Sakura-IT/decelerator4030/README.md

decelerator4030
===============

Decelerator 4030 CPU card for Amiga 3000/4000
