Sakura-IT/decelerator4030/docs/menu-specification/menu-layout.png

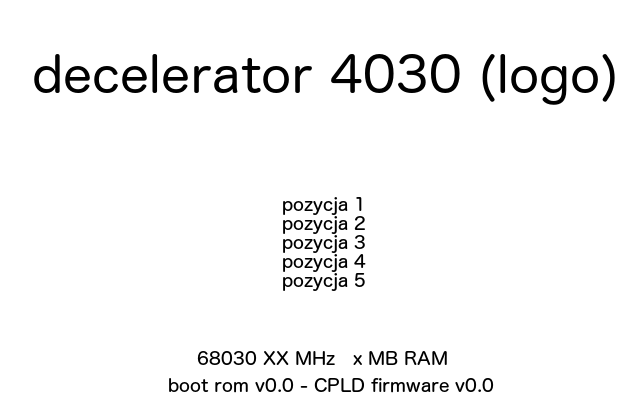
docs/menu-specification/menu-layout.png
