Sakura-IT/decelerator4030/(threads)

Thread 1 (2015-09-02):

Cannot open PCB file with latest (dev) version of pcbnew

timtashpulatov, 2015-09-02:
There seem to be a problem opening the PCB with recent versions of pcbnew. Would hate using kicad from year 2013, especially on Linux :)

rkujawa, 2015-09-02:
Yes, there's a problem, which either is a bug in KiCad, or something specific in this project. It's highly annoying but I didn't find any solution yet.

Personally I have a CentOS 6 VM for this purpose. Appropriate KiCad version from 2013 is available in EPEL for CentOS/RHEL 6. So I just ssh -X into this VM, which gives near-native experience.

I think I should ask on kicad mailing list about this instead...

sleary78, 2015-10-22:
I also experienced this issue. It cannot find any of the layers.

---------------------------
Error
---------------------------
Error loading board.
IO_ERROR: Layer 'Kleju_Dolna' in file 'C:\Users\stephen\Downloads\decelerator4030-master\board\v0.2\decelerator4030.kicad_pcb' at line 19, is not in fixed layer hash
from C:/Jenkins/workspace/windows-kicad-msys2-stable/src/kicad-4.0.0-rc1/pcbnew/pcb_parser.cpp : parseLayers() : line 829
---------------------------
OK
---------------------------

sleary78, 2015-10-22:
Perhaps related to https://forum.kicad.info/t/cant-open-the-demo-with-pcbnew/456

rkujawa, 2015-10-22:
Yes, exactly, as I mentioned above the current workaround is to use the older KiCad version. Personally I am using:
`$ rpm -q kicad`
`kicad-2013.06.11-1.rev4021.el6.x86_64`

Thread 2 (2015-12-09):

Problems with Decelerator prototype v0.2

rkujawa, 2015-12-09:
Lets use this issue to track problems with PCB design v0.2

- Provide a way to terminate the `_FPUCS` by generating `_BERR` when FPU is absent.
- Some local bus slot pins are incorrectly numbered (rows 2/3 and 6/7).
- Provide a way to block `_AS`/`_DS` delivery to main board, in case we are decoding the address on a card (not really a problem now, as we just use `_RAMSLOT`, but in the future we might want to decode it in CPLD).
- Connect `_CIIN` to CPLD, without that we can't control cache inhibit and possibly violate timings.
- Pins 119 and 120 of QFP are mismatched.

rkujawa, 2015-12-12:
Local bus slot pin numbering fixed by @jarob10 commit Sakura-IT/kicad-myparts@5dbb072d767a63a529620fdeb88b01f66f8d56a8 .

rkujawa, 2015-12-17:
`_BERR` generation when FPU is absent and QFP CPU pins mismatch fixed by @jarob10 commit c009a9950c43db73c895c168a1be03c1ebc944dd.

jarob10, 2015-12-20:
Connect _CIIN to CPLD and add pullup resistors to the Jtag by @jarob10 commit 28ce795.

jarob10, 2015-12-20:
Fix wrong PCB dimensions in rev0.3 board by @jarob10 commit 6349a9f

Thread 4 (2021-01-09):

synchronous or asynchronous operation

dymczykm, 2021-01-09:
Hi, I'm digging a bit into 68030 accelerators for old compact Macs and came across your project, it's a really neat design and a good example of interfacing a CPU to the bus.

One question that I wanted to ask if - have your ever run decelerator asynchronously w.r.t. to the system bus? My system bus operates at 16 MHz, but I would like to have 68030 at a higher frequency. Looking (briefly) at your logic equations, it seems that so far you have only forwarded the bus signals to the CPU without taking care of differing frequencies, is that correct?

Pozdrawiam!

rkujawa, 2021-01-09:
@dymczykm Correct, due to personal circumstances the project has been indefinitely delayed.

The original idea was to run the CPU asynchronously, however I have never got into that and the prototype (successfully) ran synchronously to the Amiga bus.

dymczykm, 2021-01-09:
Thanks for the quick answer - I more or less know where I stand now. In any case, the decelerator project can serve me as a nice hardware reference, thanks a lot for making it open source! :+1:

I'm not much acquainted with the Amiga world, but do you have maybe any good references regarding the asynchronous 68030 operation? I saw LUCAS and terriblefire accelerators do that for 68000->68030, I was curious if you know of logic description for 68030 or do I need to develop it from scratch.

Take care!

rkujawa, 2021-01-09:
I am not aware of any open source designs that would interface to the 68030 bus.

I think it boils down to the implementation details of the platform that you are targeting. In case of big box Amigas the local bus slot allows for both synchronous and asynchronous operation. It is even possible to drive the mainboard clocks from the CPU card. So in theory the logic on CPU board is only responsible for keeping the timings towards motherboard within limits. Unfortunately I don't remember details anymore. But I imagine in Macs it can be very different.

dymczykm, 2021-01-09:
@rkujawa thanks for the explanation. So I think some reverse engineered Mac accelerators and a 68030 User's manual will be my friends :)

Indeed, this seems to be more complex in Macs. You basically need to glue all the bus control signals (such as DSACKx, AS, DS etc. ) manually to make sure slower devices can successfully exchange data on the bus.

Thanks in any case - already a hardware concept you're sharing will be of great help!

rkujawa, 2021-01-10:
@dymczykm I guess this can be closed. Btw. If necessary you can always contact me using email address, as in commit messages of this repo.

Closed 2021-01-10.
