Sakura-IT/decelerator4030/board/v0.3/decelerator4030.kicad_pcb

## KiCad design board/v0.3/decelerator4030.kicad_pcb (2015-12-19)

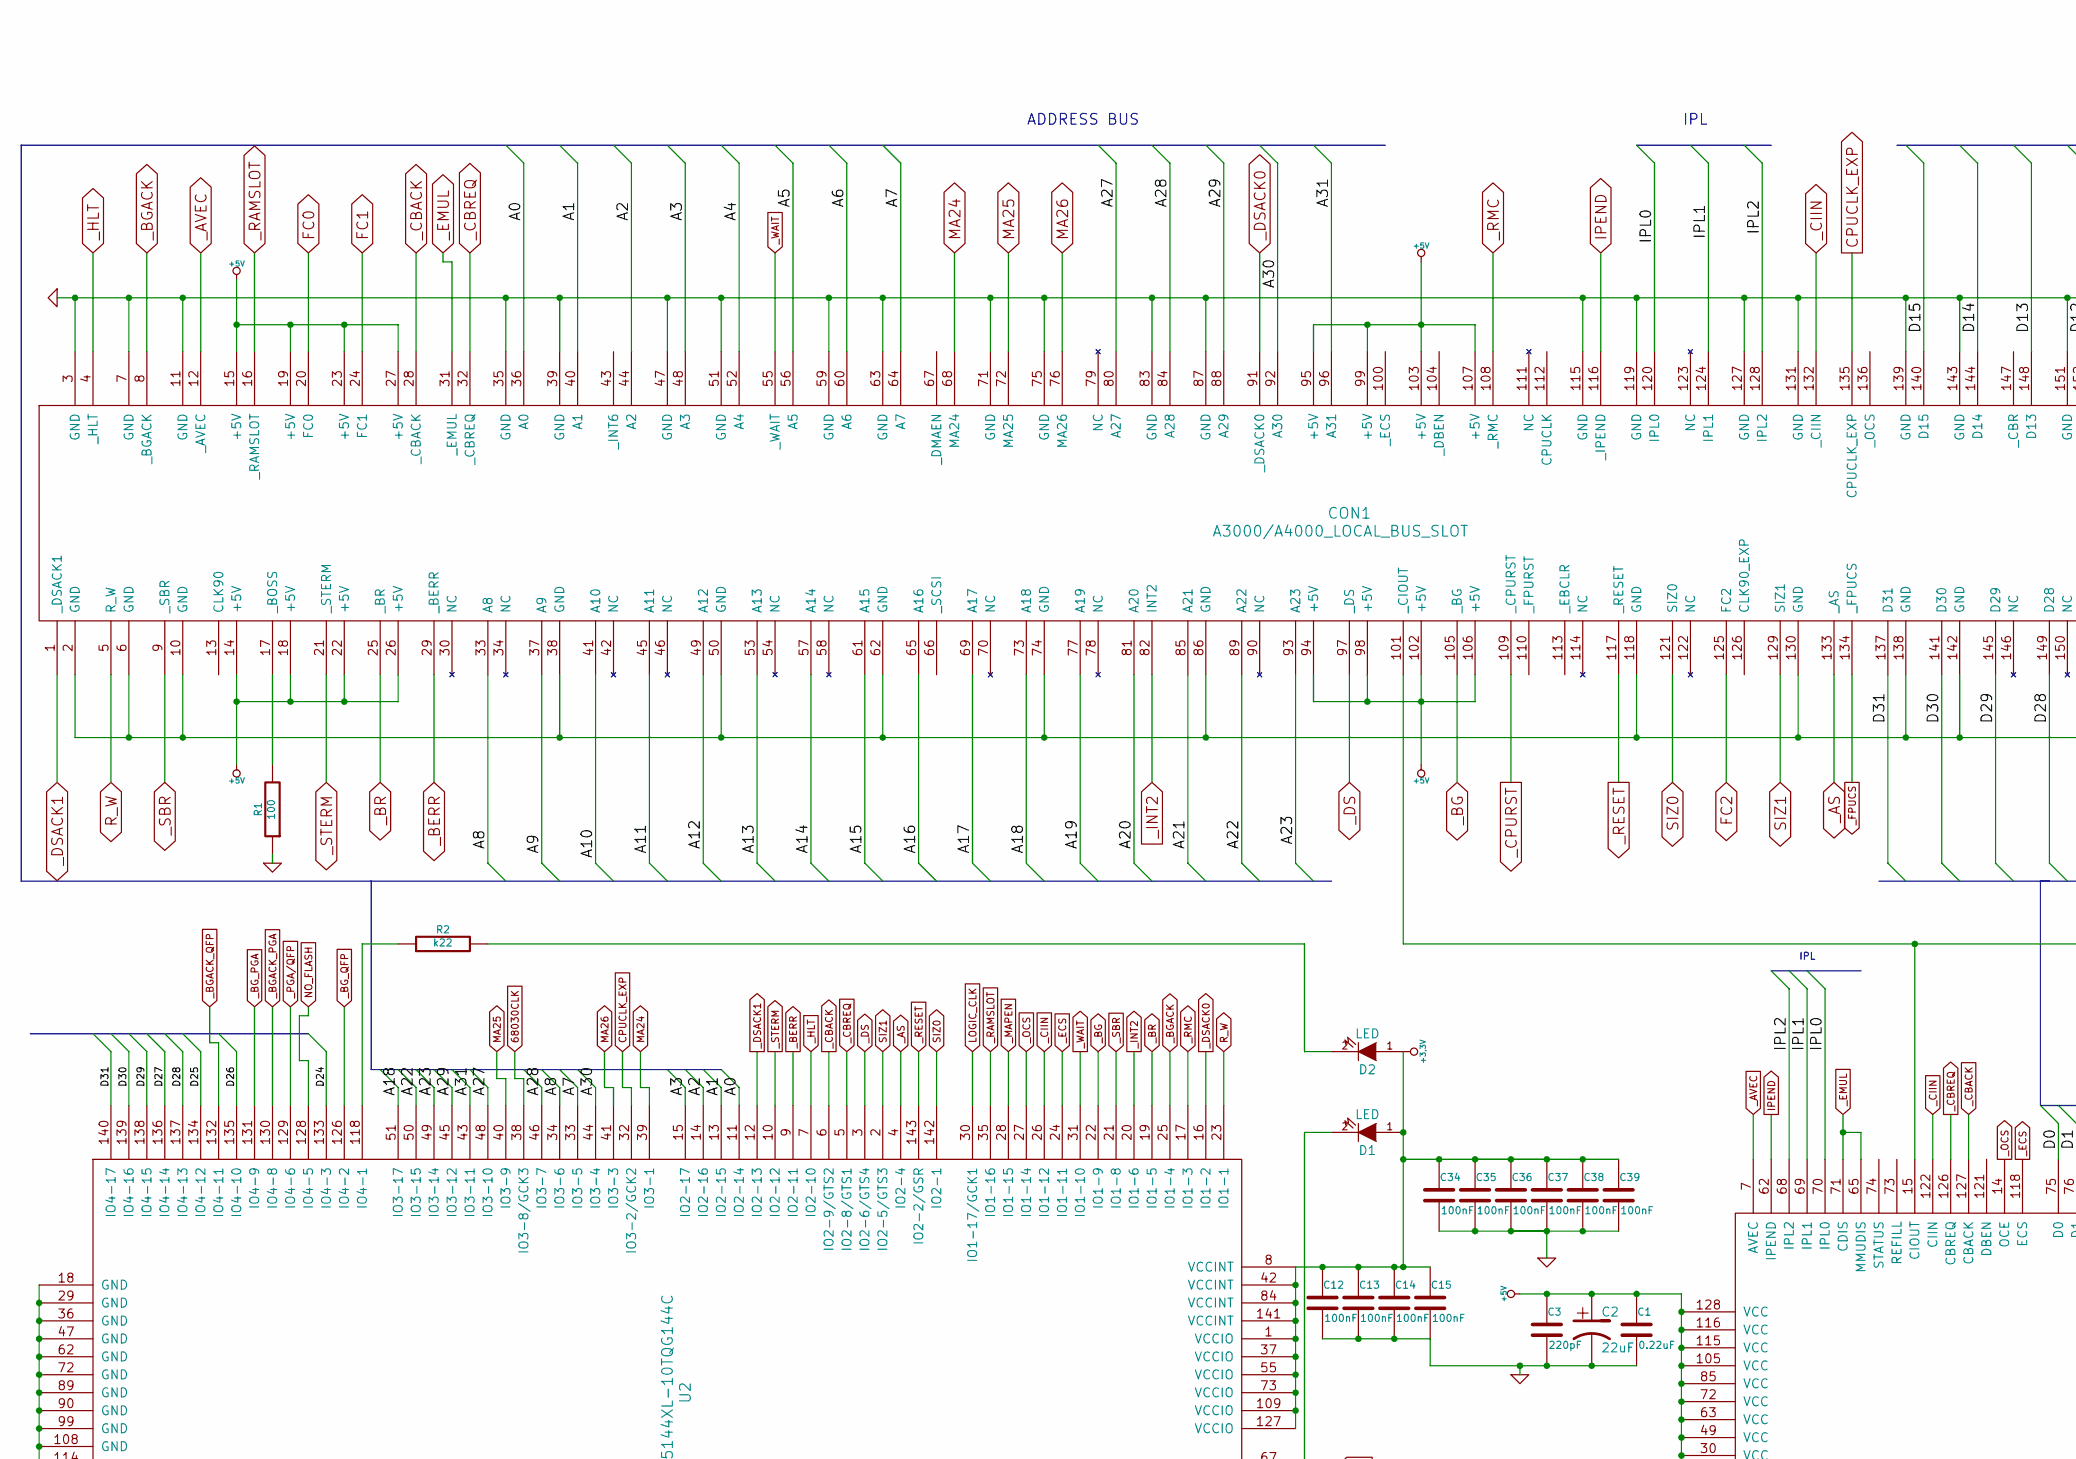
[picture p2: schematic decelerator4030.sch, part in row 1, column 1]

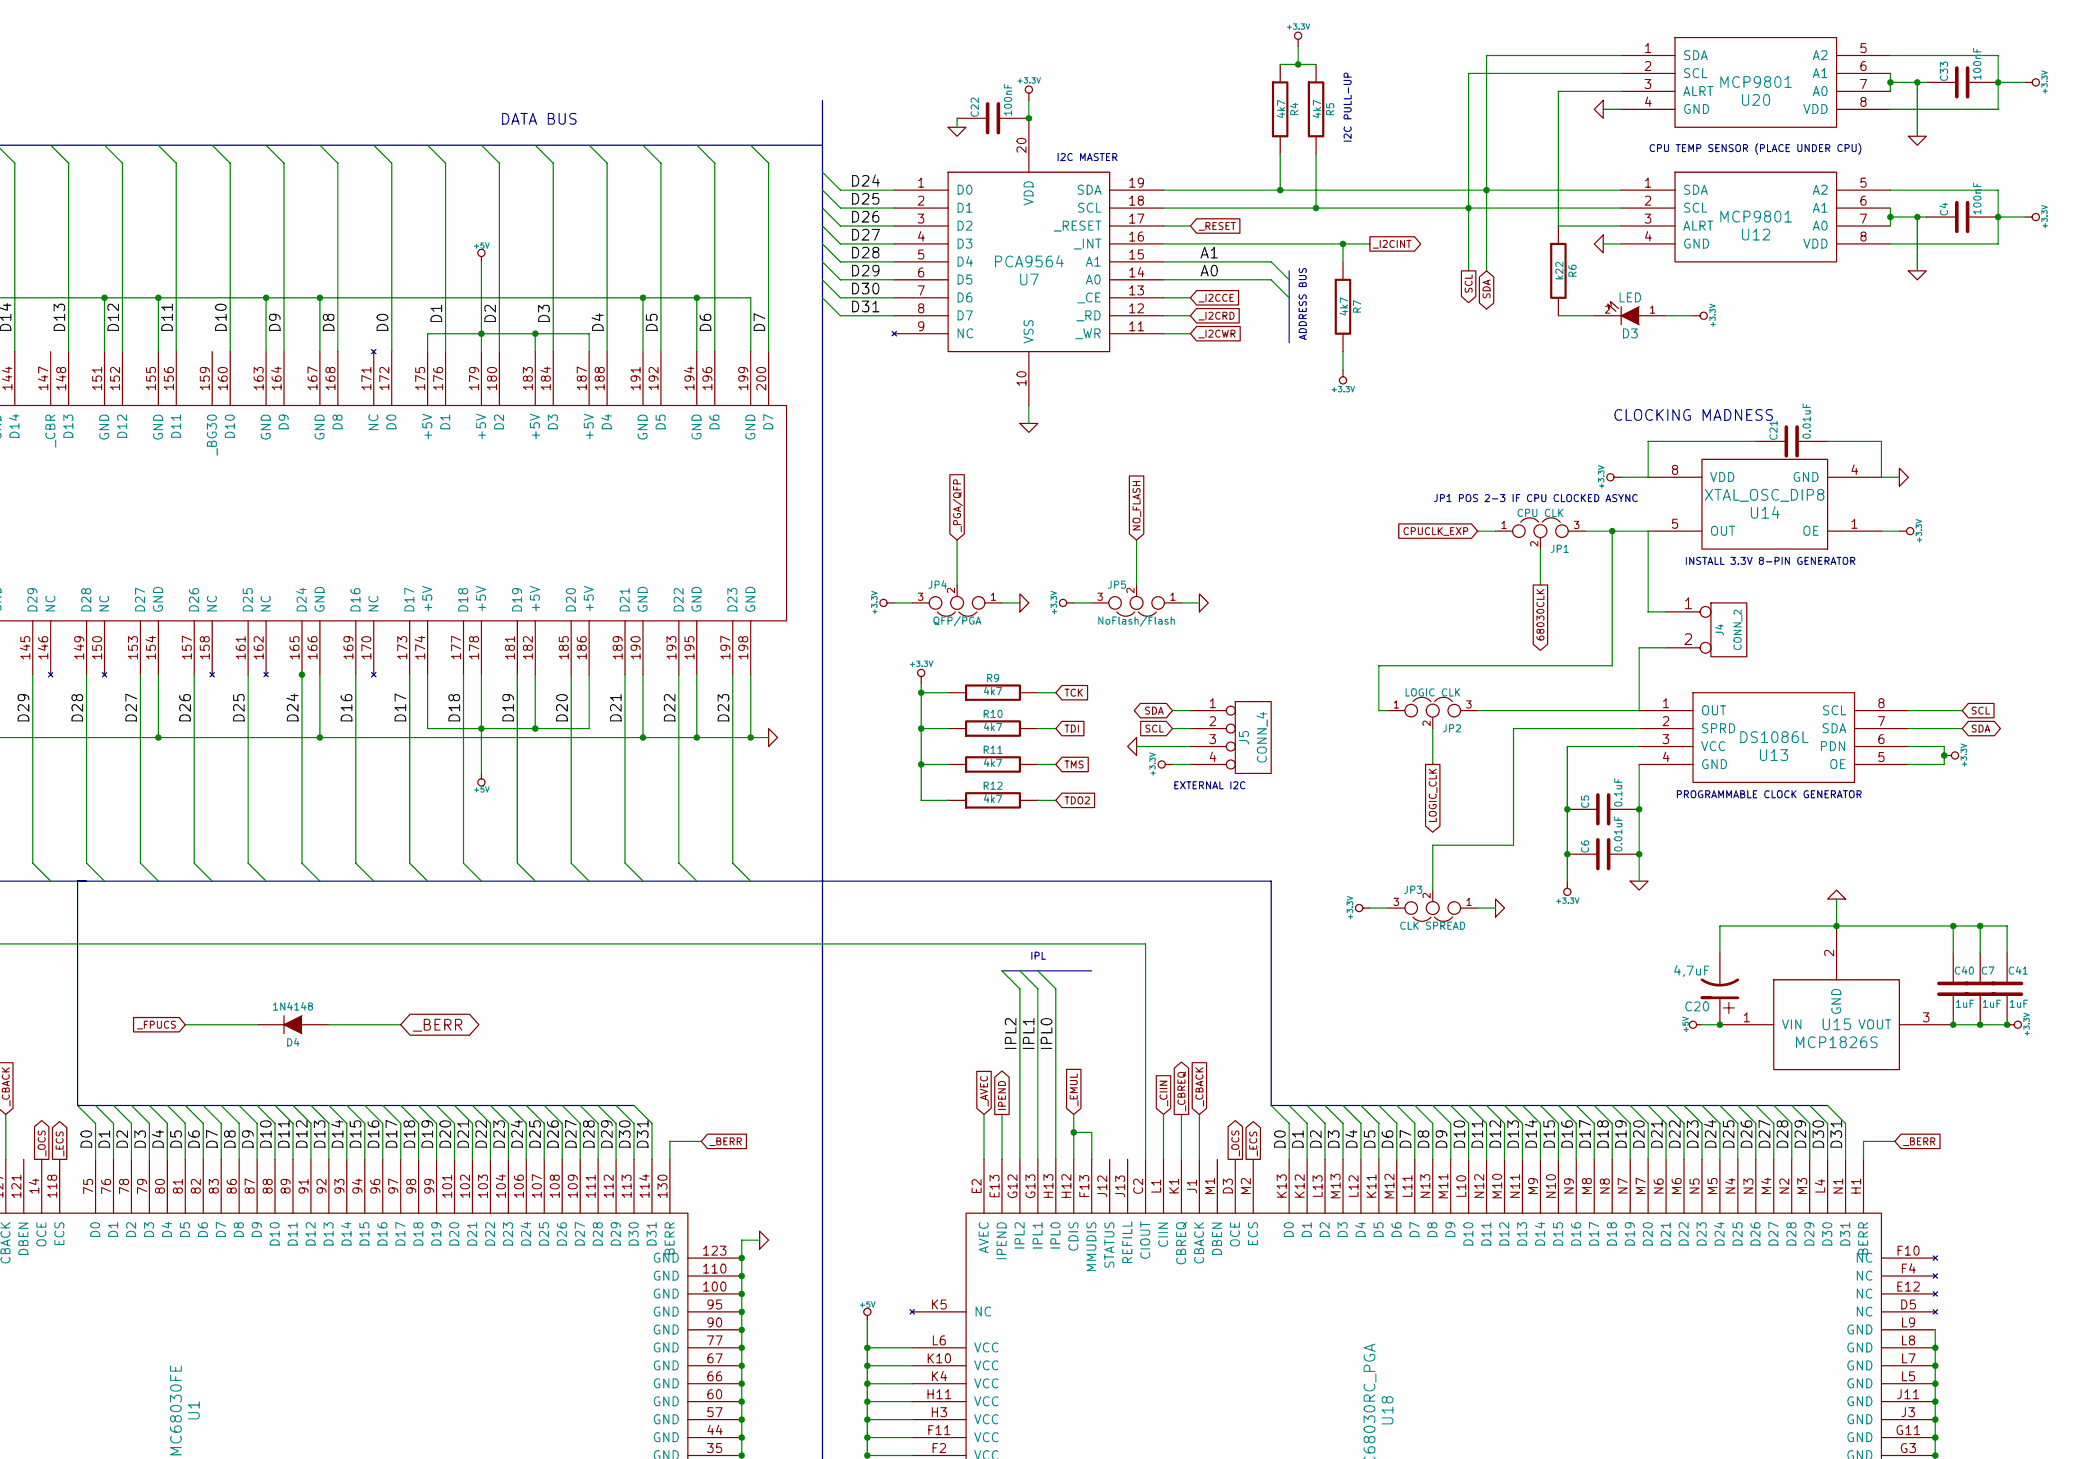
[picture p3: schematic decelerator4030.sch, part in row 1, column 2]

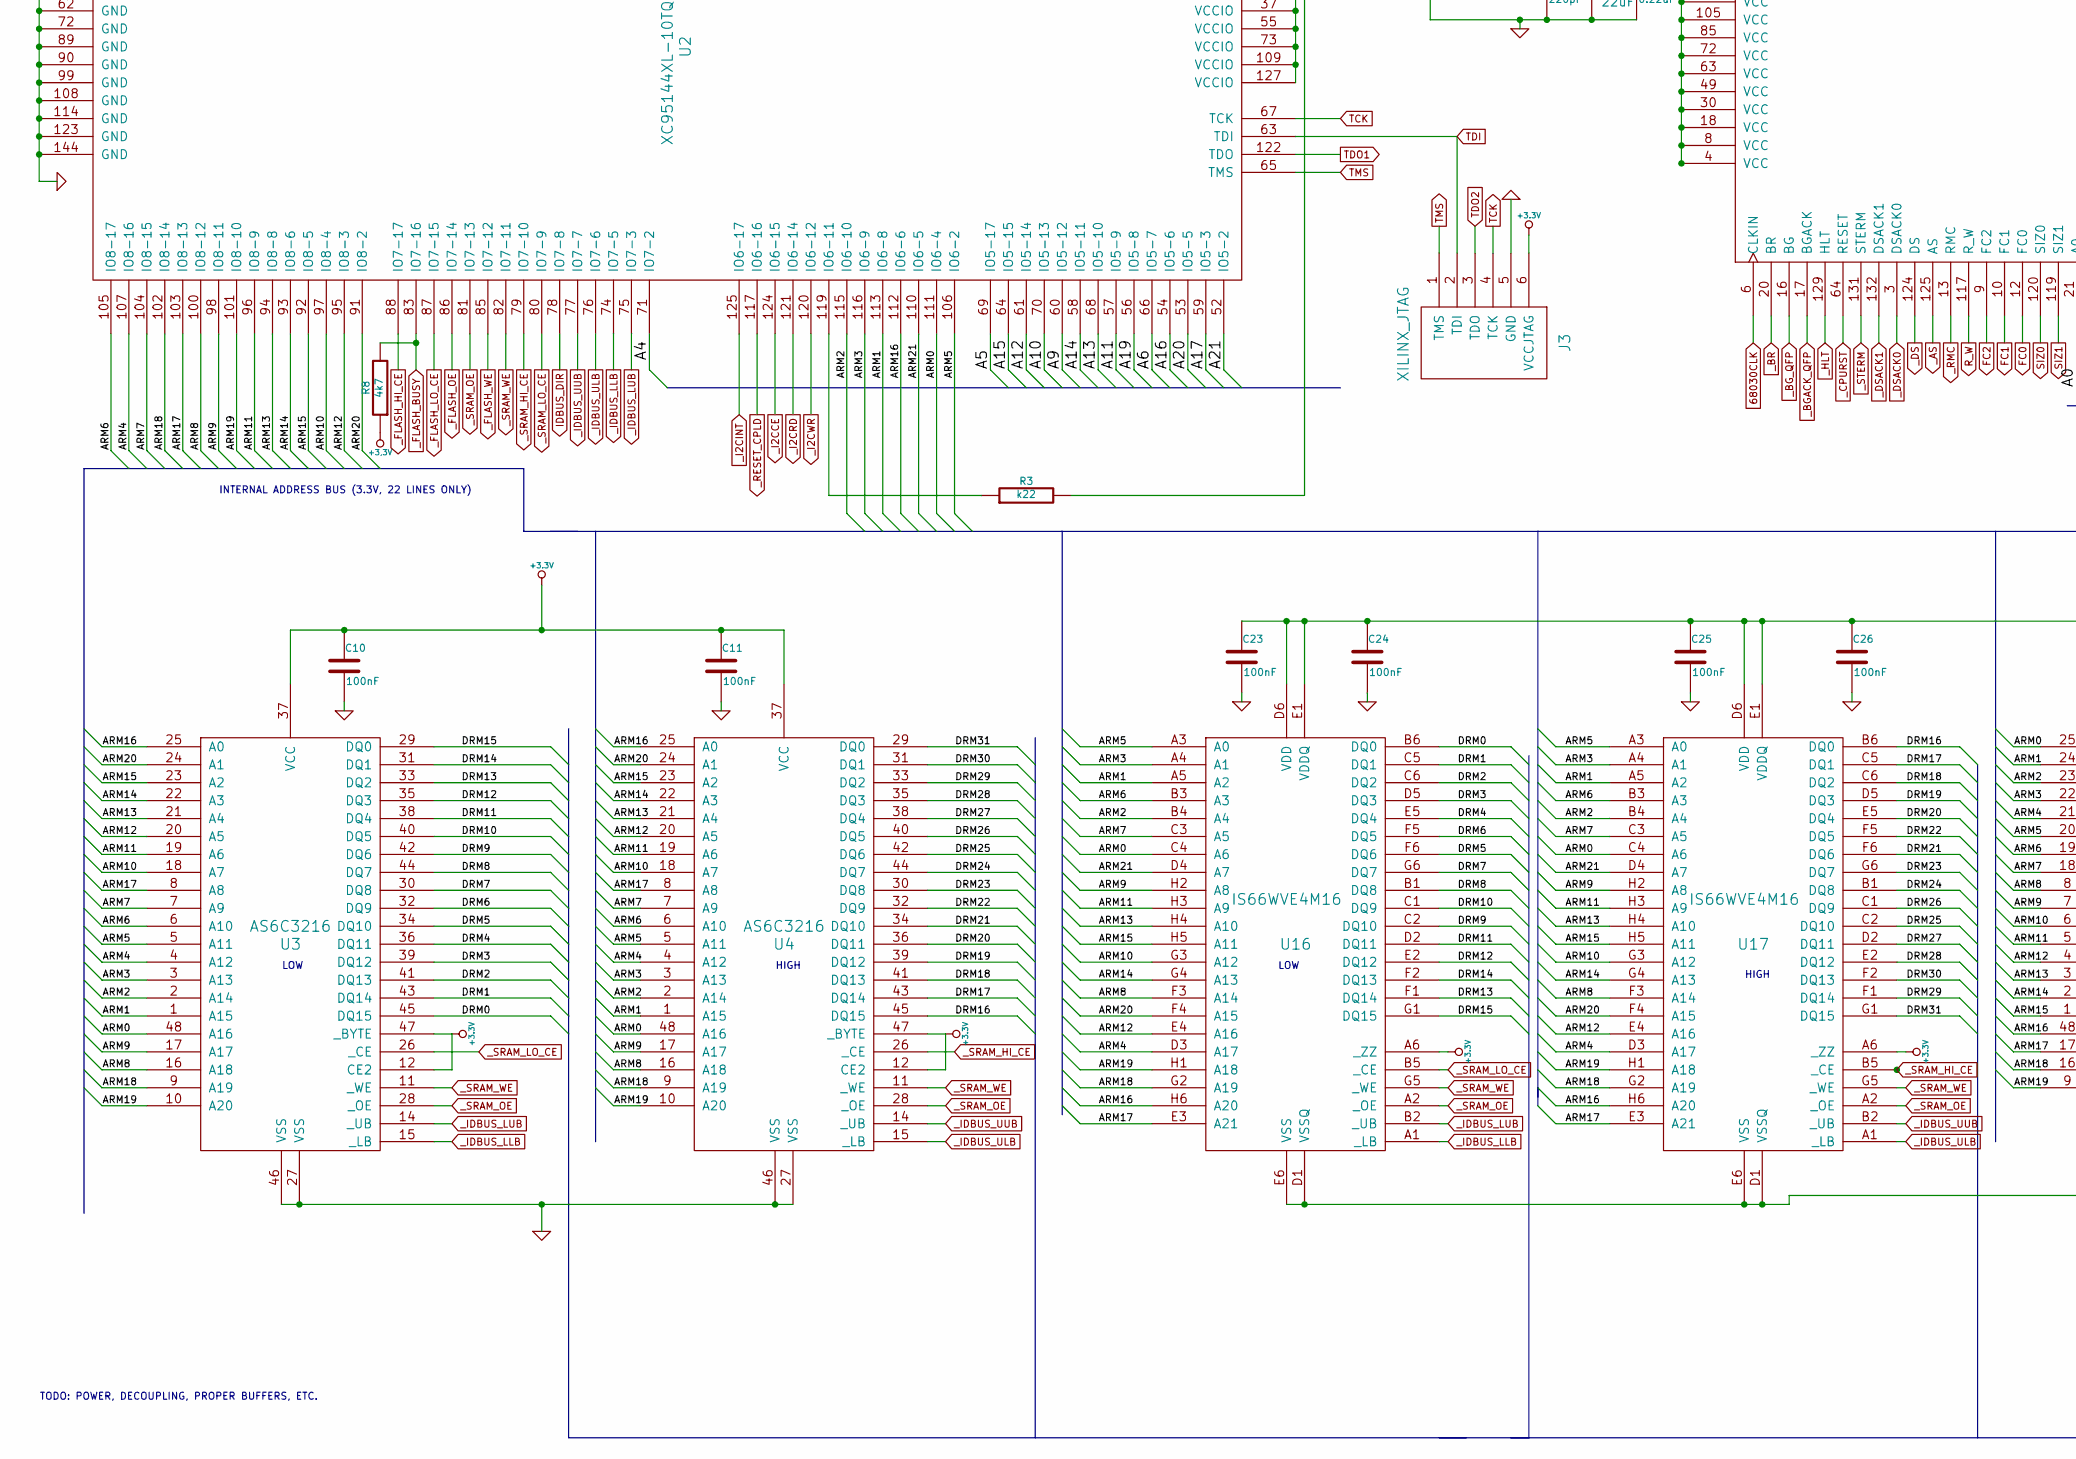
[picture p4: schematic decelerator4030.sch, part in row 2, column 1]

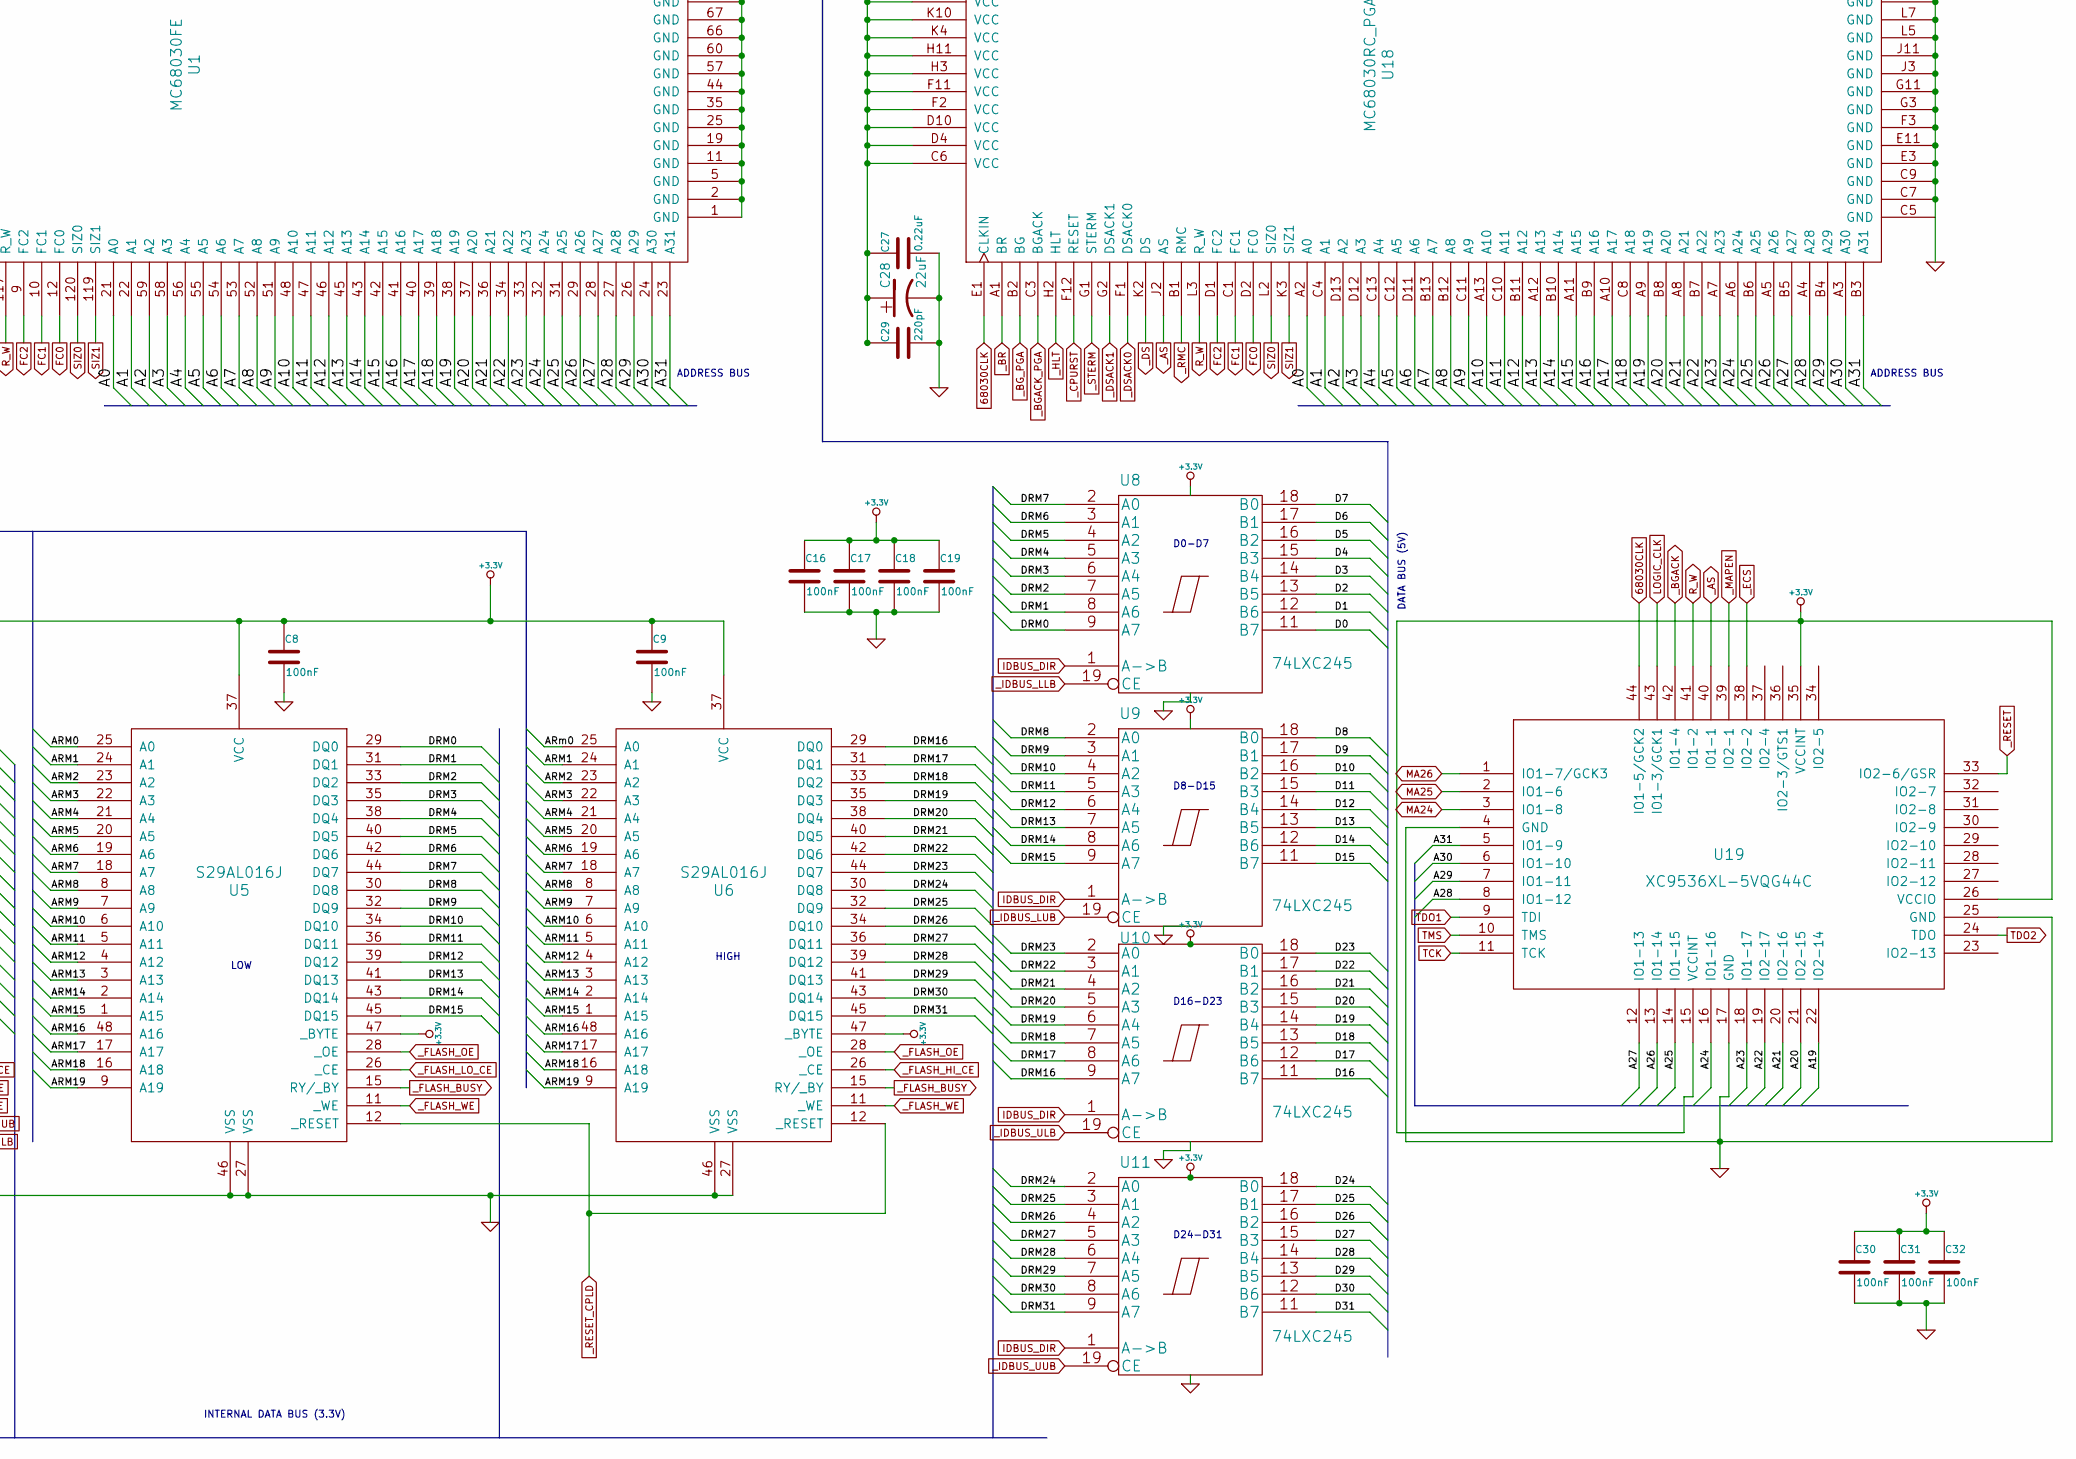
[picture p5: schematic decelerator4030.sch, part in row 2, column 2]

Parts:
C1, C27: 0.22uF
C2, C28: 22uF
C3, C29: 220pF
C4, C8, C9, C10, C11, C12, C13, C14, C15, C16, C17, C18, C19, C22, C23, C24, C25, C26, C30, C31, C32, C33, C34, C35, C36, C37, C38, C39: 100nF
C5: 0.1uF
C6, C21: 0.01uF
C7, C40, C41: 1uF
C20: 4,7uF
CON1: A3000/A4000_LOCAL_BUS_SLOT
D1, D2, D3: LED
D4: 1N4148
J3: XILINX_JTAG
J4: CONN_2
J5: CONN_4
JP1: CPU CLK
JP2: LOGIC CLK
JP3: CLK SPREAD
JP4: QFP/PGA
JP5: NoFlash/Flash
R1: 100
R2, R3, R6: k22
R4, R5, R7, R8, R9, R10, R11, R12: 4k7
U1: MC68030FE
U2: XC95144XL-10TQG144C
U3, U4: AS6C3216
U5, U6: S29AL016J
U7: PCA9564
U8, U9, U10, U11: 74LXC245
U12, U20: MCP9801
U13: DS1086L
U14: XTAL_OSC_DIP8
U15: MCP1826S
U16, U17: IS66WVE4M16
U18: MC68030RC_PGA
U19: XC9536XL-5VQG44C

Connections:
68030CLK: JP1.2, U1.6 (CLKIN), U2.38 (IO3-8/GCK3), U18.E1 (CLKIN), U19.44 (IO1-5/GCK2)
+5V: C1.1, C2.1, C3.1, C20.1, C27.1, C28.1, C29.1, CON1.14 (+5V), CON1.15 (+5V), CON1.18 (+5V), CON1.19 (+5V), CON1.22 (+5V), CON1.23 (+5V), CON1.26 (+5V), CON1.27 (+5V), CON1.94 (+5V), CON1.95 (+5V), CON1.98 (+5V), CON1.99 (+5V), CON1.102 (+5V), CON1.103 (+5V), CON1.106 (+5V), CON1.107 (+5V), CON1.174 (+5V), CON1.175 (+5V), CON1.178 (+5V), CON1.179 (+5V), CON1.182 (+5V), CON1.183 (+5V), CON1.186 (+5V), CON1.187 (+5V), U1.4 (VCC), U1.8 (VCC), U1.18 (VCC), U1.30 (VCC), U1.49 (VCC), U1.63 (VCC), U1.72 (VCC), U1.85 (VCC), U1.105 (VCC), U1.115 (VCC), U1.116 (VCC), U1.128 (VCC), U15.1 (VIN), U18.C6 (VCC), U18.D4 (VCC), U18.D10 (VCC), U18.F2 (VCC), U18.F11 (VCC), U18.H3 (VCC), U18.H11 (VCC), U18.K4 (VCC), U18.K10 (VCC), U18.L6 (VCC)
/A0: CON1.36 (A0), U1.21 (A0), U2.11 (IO2-14), U7.14 (A0), U18.A2 (A0)
/A1: CON1.40 (A1), U1.22 (A1), U2.13 (IO2-15), U7.15 (A1), U18.C4 (A1)
/A2: CON1.44 (A2), U1.59 (A2), U2.14 (IO2-16), U18.D13 (A2)
/A3: CON1.48 (A3), U1.58 (A3), U2.15 (IO2-17), U18.D12 (A3)
/A4: CON1.52 (A4), U1.56 (A4), U2.71 (IO7-2), U18.C13 (A4)
/A5: CON1.56 (A5), U1.55 (A5), U2.69 (IO5-17), U18.C12 (A5)
/A6: CON1.60 (A6), U1.54 (A6), U2.66 (IO5-7), U18.D11 (A6)
/A7: CON1.64 (A7), U1.53 (A7), U2.33 (IO3-5), U18.B13 (A7)
/A8: CON1.33 (A8), U1.52 (A8), U2.34 (IO3-6), U18.B12 (A8)
/A9: CON1.37 (A9), U1.51 (A9), U2.60 (IO5-12), U18.C11 (A9)
/A10: CON1.41 (A10), U1.48 (A10), U2.70 (IO5-13), U18.A13 (A10)
/A11: CON1.45 (A11), U1.47 (A11), U2.57 (IO5-9), U18.C10 (A11)
/A12: CON1.49 (A12), U1.46 (A12), U2.61 (IO5-14), U18.B11 (A12)
/A13: CON1.53 (A13), U1.45 (A13), U2.68 (IO5-10), U18.A12 (A13)
/A14: CON1.57 (A14), U1.43 (A14), U2.58 (IO5-11), U18.B10 (A14)
/A15: CON1.61 (A15), U1.42 (A15), U2.64 (IO5-15), U18.A11 (A15)
/A16: CON1.65 (A16), U1.41 (A16), U2.54 (IO5-6), U18.B9 (A16)
/A17: CON1.69 (A17), U1.40 (A17), U2.59 (IO5-3), U18.A10 (A17)
/A18: CON1.73 (A18), U1.39 (A18), U2.51 (IO3-17), U18.C8 (A18)
/A19: CON1.77 (A19), U1.38 (A19), U2.56 (IO5-8), U18.A9 (A19), U19.22 (IO2-14)
/A20: CON1.81 (A20), U1.37 (A20), U2.53 (IO5-5), U18.B8 (A20), U19.21 (IO2-15)
/A21: CON1.85 (A21), U1.36 (A21), U2.52 (IO5-2), U18.A8 (A21), U19.20 (IO2-16)
/A22: CON1.89 (A22), U1.34 (A22), U2.50 (IO3-15), U18.B7 (A22), U19.19 (IO2-17)
/A23: CON1.93 (A23), U1.33 (A23), U2.49 (IO3-14), U18.A7 (A23), U19.18 (IO1-17)
/A24: U1.32 (A24), U18.A6 (A24), U19.16 (IO1-16)
/A25: U1.31 (A25), U18.B6 (A25), U19.14 (IO1-15)
/A26: U1.29 (A26), U18.A5 (A26), U19.13 (IO1-14)
/A27: CON1.80 (A27), U1.28 (A27), U2.48 (IO3-10), U18.B5 (A27), U19.12 (IO1-13)
/A28: CON1.84 (A28), U1.27 (A28), U2.46 (IO3-7), U18.A4 (A28), U19.8 (IO1-12)
/A29: CON1.88 (A29), U1.26 (A29), U2.45 (IO3-12), U18.B4 (A29), U19.7 (IO1-11)
/A30: CON1.92 (A30), U1.24 (A30), U2.44 (IO3-4), U18.A3 (A30), U19.6 (IO1-10)
/A31: CON1.96 (A31), U1.23 (A31), U2.43 (IO3-11), U18.B3 (A31), U19.5 (IO1-9)
/ARM0: U2.111 (IO6-4), U3.48 (A16), U4.48 (A16), U5.25 (A0), U6.25 (A0), U16.C4 (A6), U17.C4 (A6)
/ARM1: U2.113 (IO6-8), U3.1 (A15), U4.1 (A15), U5.24 (A1), U6.24 (A1), U16.A5 (A2), U17.A5 (A2)
/ARM2: U2.115 (IO6-10), U3.2 (A14), U4.2 (A14), U5.23 (A2), U6.23 (A2), U16.B4 (A4), U17.B4 (A4)
/ARM3: U2.116 (IO6-9), U3.3 (A13), U4.3 (A13), U5.22 (A3), U6.22 (A3), U16.A4 (A1), U17.A4 (A1)
/ARM4: U2.107 (IO8-16), U3.4 (A12), U4.4 (A12), U5.21 (A4), U6.21 (A4), U16.D3 (A17), U17.D3 (A17)
/ARM5: U2.106 (IO6-2), U3.5 (A11), U4.5 (A11), U5.20 (A5), U6.20 (A5), U16.A3 (A0), U17.A3 (A0)
/ARM6: U2.105 (IO8-17), U3.6 (A10), U4.6 (A10), U5.19 (A6), U6.19 (A6), U16.B3 (A3), U17.B3 (A3)
/ARM7: U2.104 (IO8-15), U3.7 (A9), U4.7 (A9), U5.18 (A7), U6.18 (A7), U16.C3 (A5), U17.C3 (A5)
/ARM8: U2.100 (IO8-12), U3.16 (A18), U4.16 (A18), U5.8 (A8), U6.8 (A8), U16.F3 (A14), U17.F3 (A14)
/ARM9: U2.98 (IO8-11), U3.17 (A17), U4.17 (A17), U5.7 (A9), U6.7 (A9), U16.H2 (A8), U17.H2 (A8)
/ARM10: U2.97 (IO8-4), U3.18 (A7), U4.18 (A7), U5.6 (A10), U6.6 (A10), U16.G3 (A12), U17.G3 (A12)
/ARM11: U2.96 (IO8-9), U3.19 (A6), U4.19 (A6), U5.5 (A11), U6.5 (A11), U16.H3 (A9), U17.H3 (A9)
/ARM12: U2.95 (IO8-3), U3.20 (A5), U4.20 (A5), U5.4 (A12), U6.4 (A12), U16.E4 (A16), U17.E4 (A16)
/ARM13: U2.94 (IO8-8), U3.21 (A4), U4.21 (A4), U5.3 (A13), U6.3 (A13), U16.H4 (A10), U17.H4 (A10)
/ARM14: U2.93 (IO8-6), U3.22 (A3), U4.22 (A3), U5.2 (A14), U6.2 (A14), U16.G4 (A13), U17.G4 (A13)
/ARM15: U2.92 (IO8-5), U3.23 (A2), U4.23 (A2), U5.1 (A15), U6.1 (A15), U16.H5 (A11), U17.H5 (A11)
/ARM16: U2.112 (IO6-6), U3.25 (A0), U4.25 (A0), U5.48 (A16), U6.48 (A16), U16.H6 (A20), U17.H6 (A20)
/ARM17: U2.103 (IO8-13), U3.8 (A8), U4.8 (A8), U5.17 (A17), U6.17 (A17), U16.E3 (A21), U17.E3 (A21)
/ARM18: U2.102 (IO8-14), U3.9 (A19), U4.9 (A19), U5.16 (A18), U6.16 (A18), U16.G2 (A19), U17.G2 (A19)
/ARM19: U2.101 (IO8-10), U3.10 (A20), U4.10 (A20), U5.9 (A19), U6.9 (A19), U16.H1 (A18), U17.H1 (A18)
/ARM20: U2.91 (IO8-2), U3.24 (A1), U4.24 (A1), U16.F4 (A15), U17.F4 (A15)
/ARM21: U2.110 (IO6-5), U16.D4 (A7), U17.D4 (A7)
/D0: CON1.172 (D0), U1.75 (D0), U8.11 (B7), U18.K13 (D0)
/D1: CON1.176 (D1), U1.76 (D1), U8.12 (B6), U18.K12 (D1)
/D2: CON1.180 (D2), U1.78 (D2), U8.13 (B5), U18.L13 (D2)
/D3: CON1.184 (D3), U1.79 (D3), U8.14 (B4), U18.M13 (D3)
/D4: CON1.188 (D4), U1.80 (D4), U8.15 (B3), U18.L12 (D4)
/D5: CON1.192 (D5), U1.81 (D5), U8.16 (B2), U18.K11 (D5)
/D6: CON1.196 (D6), U1.82 (D6), U8.17 (B1), U18.M12 (D6)
/D7: CON1.200 (D7), U1.83 (D7), U8.18 (B0), U18.L11 (D7)
/D8: CON1.168 (D8), U1.86 (D8), U9.18 (B0), U18.N13 (D8)
/D9: CON1.164 (D9), U1.87 (D9), U9.17 (B1), U18.M11 (D9)
/D10: CON1.160 (D10), U1.88 (D10), U9.16 (B2), U18.L10 (D10)
/D11: CON1.156 (D11), U1.89 (D11), U9.15 (B3), U18.N12 (D11)
/D12: CON1.152 (D12), U1.91 (D12), U9.14 (B4), U18.M10 (D12)
/D13: CON1.148 (D13), U1.92 (D13), U9.13 (B5), U18.N11 (D13)
/D14: CON1.144 (D14), U1.93 (D14), U9.12 (B6), U18.M9 (D14)
/D15: CON1.140 (D15), U1.94 (D15), U9.11 (B7), U18.N10 (D15)
/D16: CON1.169 (D16), U1.96 (D16), U10.11 (B7), U18.N9 (D16)
/D17: CON1.173 (D17), U1.97 (D17), U10.12 (B6), U18.M8 (D17)
/D18: CON1.177 (D18), U1.98 (D18), U10.13 (B5), U18.N8 (D18)
/D19: CON1.181 (D19), U1.99 (D19), U10.14 (B4), U18.N7 (D19)
/D20: CON1.185 (D20), U1.101 (D20), U10.15 (B3), U18.M7 (D20)
/D21: CON1.189 (D21), U1.102 (D21), U10.16 (B2), U18.N6 (D21)
/D22: CON1.193 (D22), U1.103 (D22), U10.17 (B1), U18.M6 (D22)
/D23: CON1.197 (D23), U1.104 (D23), U10.18 (B0), U18.N5 (D23)
/D24: CON1.165 (D24), U1.106 (D24), U2.133 (IO4-3), U7.1 (D0), U11.18 (B0), U18.M5 (D24)
/D25: CON1.161 (D25), U1.107 (D25), U2.134 (IO4-12), U7.2 (D1), U11.17 (B1), U18.N4 (D25)
/D26: CON1.157 (D26), U1.108 (D26), U2.135 (IO4-10), U7.3 (D2), U11.16 (B2), U18.N3 (D26)
/D27: CON1.153 (D27), U1.109 (D27), U2.136 (IO4-14), U7.4 (D3), U11.15 (B3), U18.M4 (D27)
/D28: CON1.149 (D28), U1.111 (D28), U2.137 (IO4-13), U7.5 (D4), U11.14 (B4), U18.N2 (D28)
/D29: CON1.145 (D29), U1.112 (D29), U2.138 (IO4-15), U7.6 (D5), U11.13 (B5), U18.M3 (D29)
/D30: CON1.141 (D30), U1.113 (D30), U2.139 (IO4-16), U7.7 (D6), U11.12 (B6), U18.L4 (D30)
/D31: CON1.137 (D31), U1.114 (D31), U2.140 (IO4-17), U7.8 (D7), U11.11 (B7), U18.N1 (D31)
/DRM0: U3.45 (DQ15), U5.29 (DQ0), U8.9 (A7), U16.B6 (DQ0)
/DRM1: U3.43 (DQ14), U5.31 (DQ1), U8.8 (A6), U16.C5 (DQ1)
/DRM2: U3.41 (DQ13), U5.33 (DQ2), U8.7 (A5), U16.C6 (DQ2)
/DRM3: U3.39 (DQ12), U5.35 (DQ3), U8.6 (A4), U16.D5 (DQ3)
/DRM4: U3.36 (DQ11), U5.38 (DQ4), U8.5 (A3), U16.E5 (DQ4)
/DRM5: U3.34 (DQ10), U5.40 (DQ5), U8.4 (A2), U16.F6 (DQ6)
/DRM6: U3.32 (DQ9), U5.42 (DQ6), U8.3 (A1), U16.F5 (DQ5)
/DRM7: U3.30 (DQ8), U5.44 (DQ7), U8.2 (A0), U16.G6 (DQ7)
/DRM8: U3.44 (DQ7), U5.30 (DQ8), U9.2 (A0), U16.B1 (DQ8)
/DRM9: U3.42 (DQ6), U5.32 (DQ9), U9.3 (A1), U16.C2 (DQ10)
/DRM10: U3.40 (DQ5), U5.34 (DQ10), U9.4 (A2), U16.C1 (DQ9)
/DRM11: U3.38 (DQ4), U5.36 (DQ11), U9.5 (A3), U16.D2 (DQ11)
/DRM12: U3.35 (DQ3), U5.39 (DQ12), U9.6 (A4), U16.E2 (DQ12)
/DRM13: U3.33 (DQ2), U5.41 (DQ13), U9.7 (A5), U16.F1 (DQ14)
/DRM14: U3.31 (DQ1), U5.43 (DQ14), U9.8 (A6), U16.F2 (DQ13)
/DRM15: U3.29 (DQ0), U5.45 (DQ15), U9.9 (A7), U16.G1 (DQ15)
/DRM16: U4.45 (DQ15), U6.29 (DQ0), U10.9 (A7), U17.B6 (DQ0)
/DRM17: U4.43 (DQ14), U6.31 (DQ1), U10.8 (A6), U17.C5 (DQ1)
/DRM18: U4.41 (DQ13), U6.33 (DQ2), U10.7 (A5), U17.C6 (DQ2)
/DRM19: U4.39 (DQ12), U6.35 (DQ3), U10.6 (A4), U17.D5 (DQ3)
/DRM20: U4.36 (DQ11), U6.38 (DQ4), U10.5 (A3), U17.E5 (DQ4)
/DRM21: U4.34 (DQ10), U6.40 (DQ5), U10.4 (A2), U17.F6 (DQ6)
/DRM22: U4.32 (DQ9), U6.42 (DQ6), U10.3 (A1), U17.F5 (DQ5)
/DRM23: U4.30 (DQ8), U6.44 (DQ7), U10.2 (A0), U17.G6 (DQ7)
/DRM24: U4.44 (DQ7), U6.30 (DQ8), U11.2 (A0), U17.B1 (DQ8)
/DRM25: U4.42 (DQ6), U6.32 (DQ9), U11.3 (A1), U17.C2 (DQ10)
/DRM26: U4.40 (DQ5), U6.34 (DQ10), U11.4 (A2), U17.C1 (DQ9)
/DRM27: U4.38 (DQ4), U6.36 (DQ11), U11.5 (A3), U17.D2 (DQ11)
/DRM28: U4.35 (DQ3), U6.39 (DQ12), U11.6 (A4), U17.E2 (DQ12)
/DRM29: U4.33 (DQ2), U6.41 (DQ13), U11.7 (A5), U17.F1 (DQ14)
/DRM30: U4.31 (DQ1), U6.43 (DQ14), U11.8 (A6), U17.F2 (DQ13)
/DRM31: U4.29 (DQ0), U6.45 (DQ15), U11.9 (A7), U17.G1 (DQ15)
/IPL0: CON1.120 (IPL0), U1.70 (IPL0), U18.H13 (IPL0)
/IPL1: CON1.124 (IPL1), U1.69 (IPL1), U18.G13 (IPL1)
/IPL2: CON1.128 (IPL2), U1.68 (IPL2), U18.G12 (IPL2)
CPUCLK_EXP: CON1.135 (CPUCLK_EXP), JP1.1, U2.32 (IO3-2/GCK2)
FC0: CON1.20 (FC0), U1.12 (FC0), U18.D2 (FC0)
FC1: CON1.24 (FC1), U1.10 (FC1), U18.C1 (FC1)
FC2: CON1.125 (FC2), U1.9 (FC2), U18.D1 (FC2)
GND: C1.2, C2.2, C3.2, C4.1, C5.2, C6.2, C7.1, C8.2, C9.2, C10.2, C11.2, C12.2, C13.2, C14.2, C15.2, C16.2, C17.2, C18.2, C19.2, C20.2, C21.2, C22.1, C23.2, C24.2, C25.2, C26.2, C27.2, C28.2, C29.2, C30.2, C31.2, C32.2, C33.1, C34.2, C35.2, C36.2, C37.2, C38.2, C39.2, C40.1, C41.1, CON1.2 (GND), CON1.3 (GND), CON1.6 (GND), CON1.7 (GND), CON1.10 (GND), CON1.11 (GND), CON1.35 (GND), CON1.38 (GND), CON1.39 (GND), CON1.47 (GND), CON1.50 (GND), CON1.51 (GND), CON1.59 (GND), CON1.62 (GND), CON1.63 (GND), CON1.71 (GND), CON1.74 (GND), CON1.75 (GND), CON1.83 (GND), CON1.86 (GND), CON1.87 (GND), CON1.115 (GND), CON1.118 (GND), CON1.119 (GND), CON1.127 (GND), CON1.130 (GND), CON1.131 (GND), CON1.138 (GND), CON1.139 (GND), CON1.142 (GND), CON1.143 (GND), CON1.151 (GND), CON1.154 (GND), CON1.155 (GND), CON1.163 (GND), CON1.166 (GND), CON1.167 (GND), CON1.190 (GND), CON1.191 (GND), CON1.194 (GND), CON1.195 (GND), CON1.198 (GND), CON1.199 (GND), J3.5 (GND), J5.3, JP3.1, JP4.1, JP5.1, R1.1, U1.1 (GND), U1.2 (GND), U1.5 (GND), U1.11 (GND), U1.19 (GND), U1.25 (GND), U1.35 (GND), U1.44 (GND), U1.57 (GND), U1.60 (GND), U1.66 (GND), U1.67 (GND), U1.77 (GND), U1.90 (GND), U1.95 (GND), U1.100 (GND), U1.110 (GND), U1.123 (GND), U2.18 (GND), U2.29 (GND), U2.36 (GND), U2.47 (GND), U2.62 (GND), U2.72 (GND), U2.89 (GND), U2.90 (GND), U2.99 (GND), U2.108 (GND), U2.114 (GND), U2.123 (GND), U2.144 (GND), U3.27 (VSS), U3.46 (VSS), U4.27 (VSS), U4.46 (VSS), U5.27 (VSS), U5.46 (VSS), U6.27 (VSS), U6.46 (VSS), U7.10 (VSS), U8.10 (GND), U9.10 (GND), U10.10 (GND), U11.10 (GND), U12.4 (GND), U12.6 (A1), U12.7 (A0), U13.4 (GND), U14.4 (GND), U15.2 (GND), U16.D1 (VSSQ), U16.E6 (VSS), U17.D1 (VSSQ), U17.E6 (VSS), U18.C7 (GND), U18.C9 (GND), U18.E3 (GND), U18.E11 (GND), U18.F3 (GND), U18.G3 (GND), U18.G11 (GND), U18.J3 (GND), U18.J11 (GND), U18.L5 (GND), U18.L7 (GND), U18.L8 (GND), U18.L9 (GND), U19.4 (GND), U19.17 (GND), U19.25 (GND), U20.4 (GND), U20.6 (A1), U20.7 (A0); also elsewhere on the board
IDBUS_DIR: U2.78 (IO7-8), U8.1 (A->B), U9.1 (A->B), U10.1 (A->B), U11.1 (A->B)
IPEND: CON1.116 (_IPEND), U1.62 (IPEND), U18.E13 (IPEND)
LOGIC_CLK: JP2.2, U2.30 (IO1-17/GCK1), U19.43 (IO1-3/GCK1)
MA24: CON1.68 (MA24), U2.39 (IO3-1), U19.3 (IO1-8)
MA25: CON1.72 (MA25), U2.40 (IO3-9), U19.2 (IO1-6)
MA26: CON1.76 (MA26), U2.41 (IO3-3), U19.1 (IO1-7/GCK3)
unnamed: CON1.17 (_BOSS), R1.2
unnamed: CON1.101 (_CIOUT), U1.15 (CIOUT), U18.C2 (CIOUT)
unnamed: R2.1, U2.118 (IO4-1)
unnamed: D2.2 (K), R2.2
unnamed: R3.1, U2.119 (IO6-11)
unnamed: D1.2 (K), R3.2
unnamed: R6.1, U12.3 (ALRT), U20.3 (ALRT)
unnamed: J4.1, JP1.3, JP2.1, U14.5 (OUT)
unnamed: J4.2 (PM), JP2.3, U13.1 (OUT)
unnamed: JP3.2, U13.2 (SPRD)
unnamed: D3.2 (K), R6.2
NO_FLASH: JP5.2, U2.128 (IO4-5)
R_W: CON1.5 (R_W), U1.117 (R_W), U2.23 (IO1-1), U18.L3 (R_W), U19.41 (IO1-2)
SCL: J5.2, R5.2, U7.18 (SCL), U12.2 (SCL), U13.8 (SCL), U20.2 (SCL)
SDA: J5.1, R4.2, U7.19 (SDA), U12.1 (SDA), U13.7 (SDA), U20.1 (SDA)
SIZ0: CON1.121 (SIZ0), U1.120 (SIZ0), U2.142 (IO2-1), U18.L2 (SIZ0)
SIZ1: CON1.129 (SIZ1), U1.119 (SIZ1), U2.2 (IO2-5/GTS3), U18.K3 (SIZ1)
TCK: J3.4 (TCK), R9.2, U2.67 (TCK), U19.11 (TCK)
TDI: J3.2 (TDI), R10.2, U2.63 (TDI)
TDO1: U2.122 (TDO), U19.9 (TDI)
TDO2: J3.3 (TDO), R12.2, U19.24 (TDO)
TMS: J3.1 (TMS), R11.2, U2.65 (TMS), U19.10 (TMS)
_AS: CON1.133 (_AS), U1.125 (AS), U2.4 (IO2-4), U18.J2 (AS), U19.40 (IO1-1)
_AVEC: CON1.12 (_AVEC), U1.7 (AVEC), U18.E2 (AVEC)
_BERR: CON1.29 (_BERR), D4.2 (A), U1.130 (BERR), U2.9 (IO2-11), U18.H1 (BERR)
_BG: CON1.105 (_BG), U2.22 (IO1-9)
_BGACK: CON1.8 (_BGACK), U2.25 (IO1-4), U19.42 (IO1-4)
_BGACK_PGA: U2.130 (IO4-8), U18.C3 (BGACK)
_BGACK_QFP: U1.17 (BGACK), U2.132 (IO4-11)
_BG_PGA: U2.131 (IO4-9), U18.B2 (BG)
_BG_QFP: U1.16 (BG), U2.126 (IO4-2)
_BR: CON1.25 (_BR), U1.20 (BR), U2.19 (IO1-5), U18.A1 (BR)
_CBACK: CON1.28 (_CBACK), U1.127 (CBACK), U2.6 (IO2-9/GTS2), U18.J1 (CBACK)
_CBREQ: CON1.32 (_CBREQ), U1.126 (CBREQ), U2.5 (IO2-8/GTS1), U18.K1 (CBREQ)
_CIIN: CON1.132 (_CIIN), U1.122 (CIIN), U2.26 (IO1-12), U18.L1 (CIIN)
_CPURST: CON1.109 (_CPURST), U1.64 (RESET), U18.F12 (RESET)
_DS: CON1.97 (_DS), U1.124 (DS), U2.3 (IO2-6/GTS4), U18.K2 (DS)
_DSACK0: CON1.91 (_DSACK0), U1.3 (DSACK0), U2.16 (IO1-2), U18.F1 (DSACK0)
_DSACK1: CON1.1 (_DSACK1), U1.132 (DSACK1), U2.12 (IO2-13), U18.G2 (DSACK1)
_ECS: U1.118 (ECS), U2.24 (IO1-11), U18.M2 (ECS), U19.38 (IO2-2)
_EMUL: CON1.31 (_EMUL), U1.65 (MMUDIS), U1.71 (CDIS), U18.F13 (MMUDIS), U18.H12 (CDIS)
_FLASH_BUSY: R8.2, U2.83 (IO7-16), U5.15 (RY/_BY), U6.15 (RY/_BY)
_FLASH_HI_CE: U2.88 (IO7-17), U6.26 (_CE)
_FLASH_LO_CE: U2.87 (IO7-15), U5.26 (_CE)
_FLASH_OE: U2.86 (IO7-14), U5.28 (_OE), U6.28 (_OE)
_FLASH_WE: U2.85 (IO7-12), U5.11 (_WE), U6.11 (_WE)
_FPUCS: CON1.134 (_FPUCS), D4.1 (K)
_HLT: CON1.4 (_HLT), U1.129 (HLT), U2.7 (IO2-10), U18.H2 (HLT)
_I2CCE: U2.124 (IO6-15), U7.13 (_CE)
_I2CINT: R7.1, U2.125 (IO6-17), U7.16 (_INT)
_I2CRD: U2.121 (IO6-14), U7.12 (_RD)
_I2CWR: U2.120 (IO6-12), U7.11 (_WR)
_IDBUS_LLB: U2.74 (IO7-5), U3.15 (_LB), U8.19 (CE), U16.A1 (_LB)
_IDBUS_LUB: U2.75 (IO7-3), U3.14 (_UB), U9.19 (CE), U16.B2 (_UB)
_IDBUS_ULB: U2.76 (IO7-6), U4.15 (_LB), U10.19 (CE), U17.A1 (_LB)
_IDBUS_UUB: U2.77 (IO7-7), U4.14 (_UB), U11.19 (CE), U17.B2 (_UB)
_INT2: CON1.82 (INT2), U2.20 (IO1-6)
_MAPEN: U2.28 (IO1-15), U19.39 (IO2-1)
_OCS: U1.14 (OCE), U2.27 (IO1-14), U18.D3 (OCE)
_PGA/QFP: JP4.2, U2.129 (IO4-6)
_RAMSLOT: CON1.16 (_RAMSLOT), U2.35 (IO1-16)
_RESET: CON1.117 (_RESET), U2.143 (IO2-2/GSR), U7.17 (_RESET), U19.33 (IO2-6/GSR)
_RESET_CPLD: U2.117 (IO6-16), U5.12 (_RESET), U6.12 (_RESET)
_RMC: CON1.108 (_RMC), U1.13 (RMC), U2.17 (IO1-3), U18.B1 (RMC)
_SBR: CON1.9 (_SBR), U2.21 (IO1-8)
_SRAM_HI_CE: U2.79 (IO7-10), U4.26 (_CE), U17.B5 (_CE)
_SRAM_LO_CE: U2.80 (IO7-9), U3.26 (_CE), U16.B5 (_CE)
_SRAM_OE: U2.81 (IO7-13), U3.28 (_OE), U4.28 (_OE), U16.A2 (_OE), U17.A2 (_OE)
_SRAM_WE: U2.82 (IO7-11), U3.11 (_WE), U4.11 (_WE), U16.G5 (_WE), U17.G5 (_WE)
_STERM: CON1.21 (_STERM), U1.131 (STERM), U2.10 (IO2-12), U18.G1 (STERM)
_WAIT: CON1.55 (_WAIT), U2.31 (IO1-10)

Notes on the sheet:
DATA BUS
ADDRESS BUS
IPL
ADDRESS BUS
INTERNAL ADDRESS BUS (3.3V, 22 LINES ONLY)
CLOCKING MADNESS
LOW
HIGH
INTERNAL DATA BUS (3.3V)
D0-D7
D8-D15
DATA BUS (5V)
D16-D23
D24-D31
TODO: POWER, DECOUPLING, PROPER BUFFERS, ETC.
I2C MASTER
I2C PULL-UP
CPU TEMP SENSOR (PLACE UNDER CPU)
INSTALL 3.3V 8-PIN GENERATOR
PROGRAMMABLE CLOCK GENERATOR
JP1 POS 2-3 IF CPU CLOCKED ASYNC
EXTERNAL I2C

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
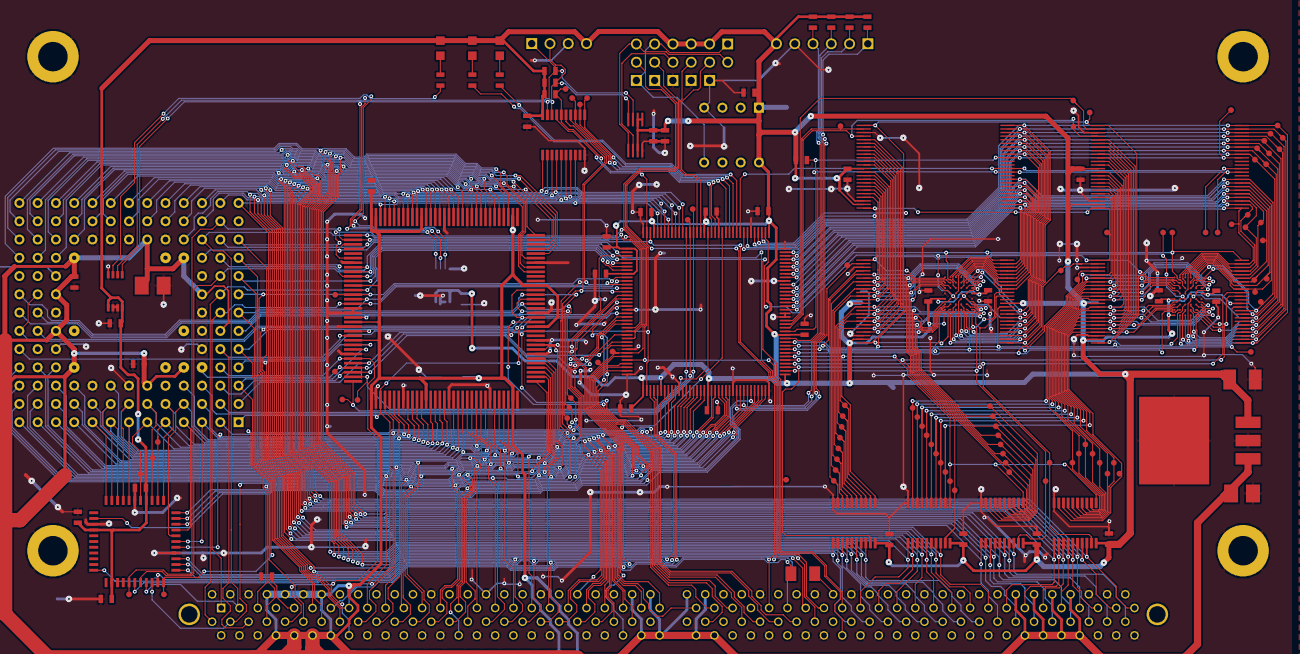
[picture p6: board decelerator4030.kicad_pcb from above]

Board: 2 copper layers, 90 parts (0 on the bottom side), 206 nets.

Other parts of the board:
Hole_4mm, Hole_4mm#2, Hole_4mm#3, Hole_4mm#4: P***; hole_4mm

Their connections:
GND: Hole_4mm.1, Hole_4mm#2.1, Hole_4mm#3.1, Hole_4mm#4.1; also elsewhere on the board
