Sakura-IT/decelerator4030/(commit log)

2014-09-07 Initial commit of prototype - just CPU connected to the slot.
    [decelerator4030.sch]
2014-09-11 Finished version 0.1.
    [decelerator4030.sch]
2014-10-11 New version board
    [decelerator4030.kicad_pcb, decelerator4030.sch]
2014-10-27 New version schematic and board
    [decelerator4030.sch]
2014-11-17 Some change boards and schematic
    [decelerator4030.kicad_pcb, decelerator4030.sch]
2014-11-23 Fixed bug pin numbering of CON1
    [decelerator4030.kicad_pcb]
2015-06-06 semifinal board prototype
    [decelerator4030.kicad_pcb, decelerator4030.sch]
2015-08-26 Final proto board and gerber files
    [decelerator4030-B_Mask.gbs, decelerator4030-B_SilkS.gbo, decelerator4030-Dolna.gbl, decelerator4030-Edge_Cuts.gbr, decelerator4030-F_Mask.gts, decelerator4030-F_SilkS.gto, decelerator4030-Gorna.gtl, decelerator4030.drl]
2015-08-27 Revert "Final proto board and gerber files"
    This reverts commit 2b0c9fd41709aa66afef538672b8e5c53e5a6036.
    [decelerator4030-B_Mask.gbs, decelerator4030-B_SilkS.gbo, decelerator4030-Dolna.gbl, decelerator4030-Edge_Cuts.gbr, decelerator4030-F_Mask.gts, decelerator4030-F_SilkS.gto, decelerator4030-Gorna.gtl, decelerator4030.drl]
2015-08-27 Revert the mistaken revert.
    This reverts commit 6991797e6b54a4bce98f1816d85600409aecea96.
    [decelerator4030-B_Mask.gbs, decelerator4030-B_SilkS.gbo, decelerator4030-Dolna.gbl, decelerator4030-Edge_Cuts.gbr, decelerator4030-F_Mask.gts, decelerator4030-F_SilkS.gto, decelerator4030-Gorna.gtl, decelerator4030.drl]
2015-10-10 Litle change of board
    [decelerator4030-B_Mask.gbs, decelerator4030-B_SilkS.gbo, decelerator4030-Dolna.gbl, decelerator4030-Edge_Cuts.gbr, decelerator4030-F_Mask.gts, decelerator4030-F_SilkS.gto, decelerator4030-Gorna.gtl, decelerator4030.drl]
2015-10-18 Finaly proto goard
    [decelerator4030.kicad_pcb]
2015-12-14 Removing errors in board
    [decelerator4030.kicad_pcb, decelerator4030.sch]
2015-12-19 Add pull up resistors and _CIIN to CPLD
    [decelerator4030.kicad_pcb, decelerator4030.sch, decelerator4030_BOM.csv]
2015-12-19 Fix bad PCB dimensions
    [decelerator4030.kicad_pcb, decelerator4030.sch, decelerator4030_BOM.csv]
